Gianducaconte/algoradix-hardware/README.md

# Algoradix hardware

<p align="center">
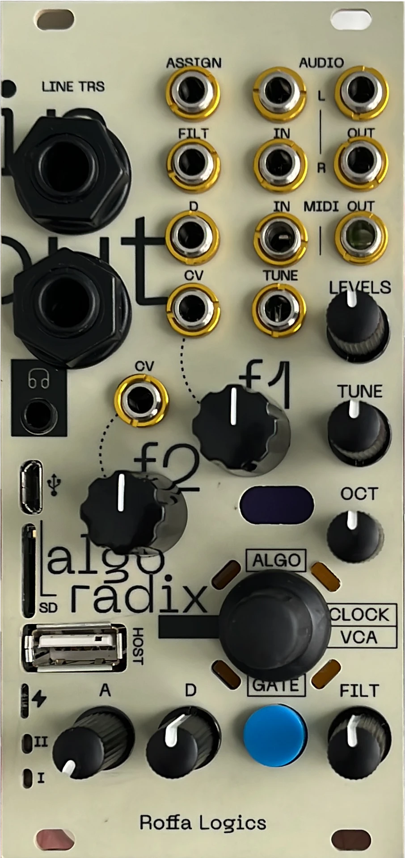
[picture p1: images/front-panel.png]
Algoradix front panel
  
</p>

**Algoradix** is a 12 HP Eurorack synth voice by **Roffa Logics**. It turns an
[Axoloti Core v1.2](https://github.com/axoloti/axoloti) into a playable module, with eight pots, six CV inputs, stereo
audio in and out, TRS MIDI in and out, a gate/function button, an encoder with four ring LEDs, and a small OLED. The
Core's own line jacks, headphone output, micro-SD, mini-USB and USB host port come through the panel.

This repository holds the open hardware: the **interface board**, the **connector board** that joins it to the
Core, the **front panel** (two colour variants), the BOM, the extracted netlist, assembly notes and photos. The
firmware is in the companion repository **[algoradix-firmware](https://github.com/Gianducaconte/algoradix-firmware)**.

| | |
|---|---|
| Format | Eurorack, 3U, 12 HP (panel 60.2 × 128.75 mm) |
| Brain | Axoloti Core v1.2: STM32F427 at 168 MHz, ADAU1961 24-bit codec at 48 kHz, 8 MB SDRAM, micro-SD |
| Controls | 8 pots (f1, f2, TUNE, OCT, A, D, FILT, LEVELS), EC11 encoder with push, GATE/FUNC button |
| CV inputs | f1, f2, TUNE (1 V/oct), D, FILT, ASSIGN. Summed with the pot in analog, 400 ADC counts per volt |
| Audio | stereo IN (attenuated to line level, right normalled to left), stereo OUT (amplified to Eurorack level) |
| MIDI | TRS IN and OUT on the panel, plus USB host (USB-A) on the Core |
| Display | SSD1306 OLED, 64 × 32, I2C |
| Power | Eurorack 10-pin, ±12 V |

## Design highlights

- **Compact.** A full Axoloti Core plus every jack, pot and the display fit in 12 HP: three boards stacked behind
  one panel, joined by a single 30-pin flat cable.
- **Real modular I/O, with protection in place.** CV inputs go through op-amps running on 3.3 V, so whatever is
  patched in, the STM32's ADC never sees a voltage outside 0…3.3 V. Each input also has a 1 kHz low-pass. Audio inputs
  are attenuated from Eurorack to line level, and outputs are amplified back up through 1 kΩ protection resistors.
  Eurorack power comes in through reverse-polarity diodes.
- **Pitch tracking from CV.** Each pot and its CV jack are summed in analog at a fixed 400 ADC counts per volt, so
  TUNE works as a 1 V/oct input.
- **A very small display.** A 0.49" 64 × 32 OLED, one of the smallest on the market, sits behind a pill-shaped
  window in the panel. The UI is designed around it: one big word per screen.
- **A PCB faceplate printed on aluminium.** The panel is an aluminium PCB with no silkscreen. The artwork is drawn
  in the **solder-mask layer, inverted**, so the PCB maker produces the print as part of the board itself. There's
  no silkscreen that might not grip on the aluminium, and the jack rings come out as plated copper.
- **Built before AI made rewriting easy, and still works both ways.** Algoradix was first designed to run patches
  from the stock Axoloti patcher, mapped onto the Core's GPIO, so the hardware works with Axoloti software too. Today
  it runs its own [firmware](https://github.com/Gianducaconte/algoradix-firmware), written from scratch.

## The build story

The PCBs were designed **in one week, in one go**, with a schematic covering only the fundamentals. The first
boards worked straight away. Only three sets were made. Every component was sourced directly from Mouser, TME and
Thonk, and everything was **assembled by hand**, including the tiny 0805 and SOIC parts on the back of the interface
board. You can see it in the [photos](#photos).

Three modules exist: two are in the designer's rack, and the third is in a friend's. **There are no plans to make more or to
sell them.** The design depends on the Axoloti Core, so it's published here instead: take it, learn from it, build on it. The [licence](#licence) keeps your derivatives open too.

## Contents

| Path | What |
|---|---|
| [`docs/architecture.md`](docs/architecture.md) | how the three boards and the Core fit together, power and signal flow |
| [`docs/interface-board.md`](docs/interface-board.md) | the interface board circuits: CV summing amplifiers, −10 V reference, audio in and out, controls |
| [`docs/pinout.md`](docs/pinout.md) | the 30-pin FPC between the boards, and every panel control mapped to its STM32 pin |
| [`docs/build-guide.md`](docs/build-guide.md) | ordering the boards and the panel, parts outside the BOM, assembly order, first power-up |
| [`pcb/interface-board/gerbers/`](pcb/interface-board/gerbers/) | Gerbers and drills, interface board (52.7 × 110.2 mm, 2 layers, SMD on the back) |
| [`pcb/connector-board/gerbers/`](pcb/connector-board/gerbers/) | Gerbers and drills, connector board (109.8 × 23.1 mm, 2 layers) |
| [`panel/variant-A/`](panel/variant-A/), [`panel/variant-B/`](panel/variant-B/) | front panel Gerbers, two artwork variants |
| [`bom/interface-board-bom.csv`](bom/interface-board-bom.csv) | interface board bill of materials (106 parts) |
| [`schematic/interface-board-netlist.txt`](schematic/interface-board-netlist.txt) | full netlist of the interface board |
| [`images/`](images/) | photos of the build, and renders of the boards and panels made from the Gerbers |

## The boards

<p>
Interface board, top
Interface board, bottom
Panel artwork, variant A
Panel artwork, variant B
</p>
Connector board, top

**Interface board.** All the panel jacks, pots, the encoder, the button and the ring LEDs. Three MCP6002 op-amps on
3.3 V sum each pot with its CV jack and scale the result to the 0–3.3 V range of the ADC. The rail-to-rail output also
protects the STM32 from out-of-range CV. Two TL072s on ±12 V buffer the audio: they bring Eurorack levels down to
line level for the codec, and line level back up for the outputs. One 30-pin FPC cable carries everything to the
connector board.

**Connector board.** Plugs onto the Core's GPIO header. It takes the FPC from the interface board, the Eurorack power
header (with reverse-polarity diodes), and breaks out power for the Core and the interface board, MIDI to the Core,
and an I2C header for the OLED.

**Panel.** An aluminium PCB with the artwork in the solder-mask layer, inverted, and no silkscreen (see
[panel/](panel/)). Variant A and variant B are the two colourways, and the photos show both.

## Photos

| | | |
|---|---|---|
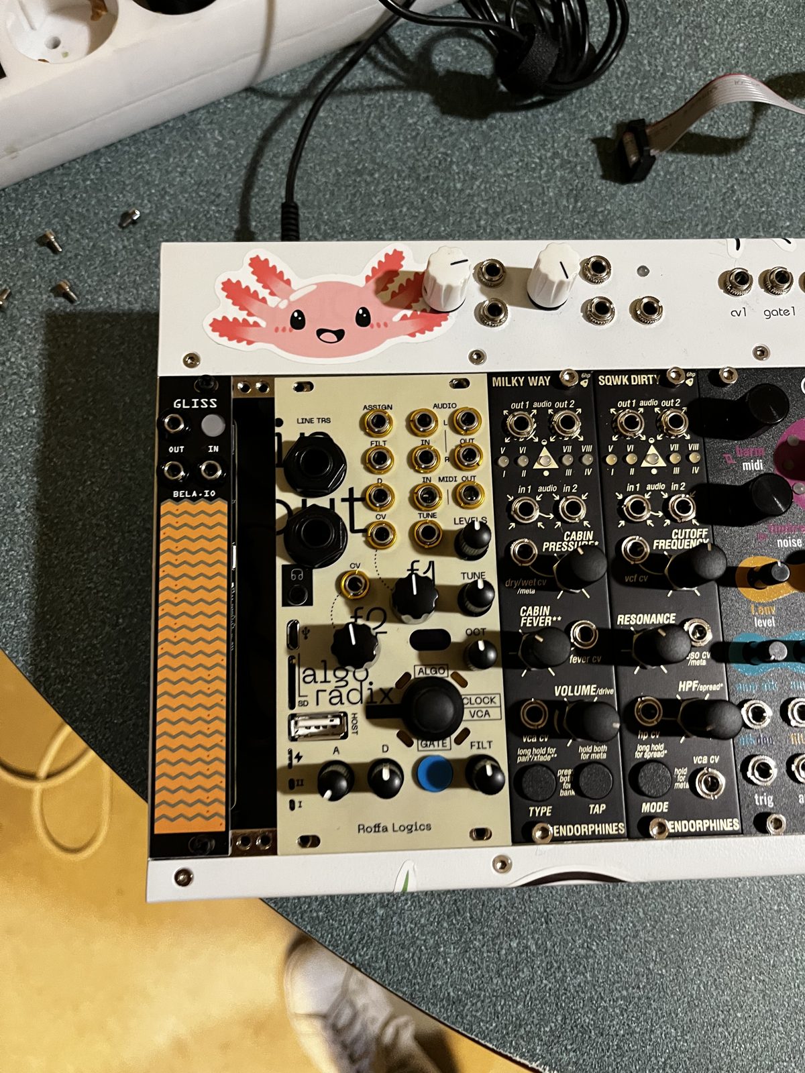
[picture p2: images/photos/03-in-rack.jpg]
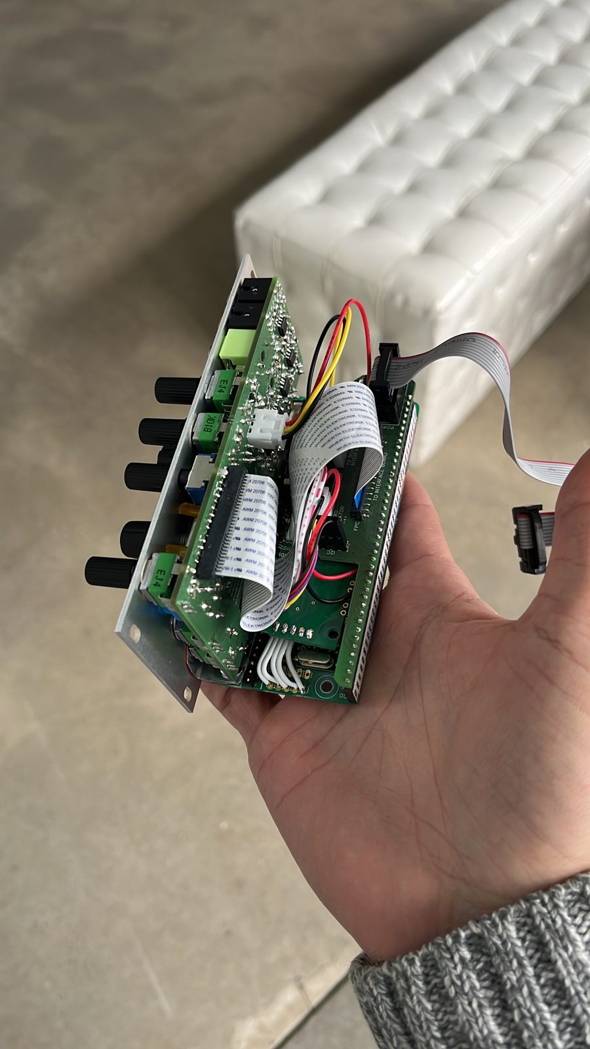
[picture p3: images/photos/02-side-stack.jpg]
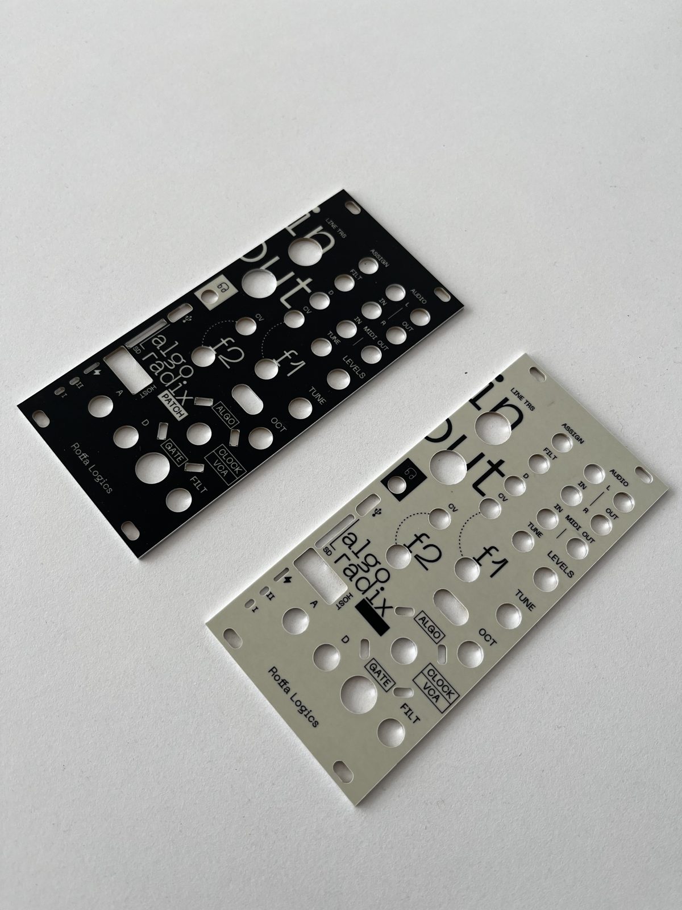
[picture p4: images/photos/04-panels-black-white.jpg]
|  |  |  |
| in the rack | the stack from the side | the two panel variants |
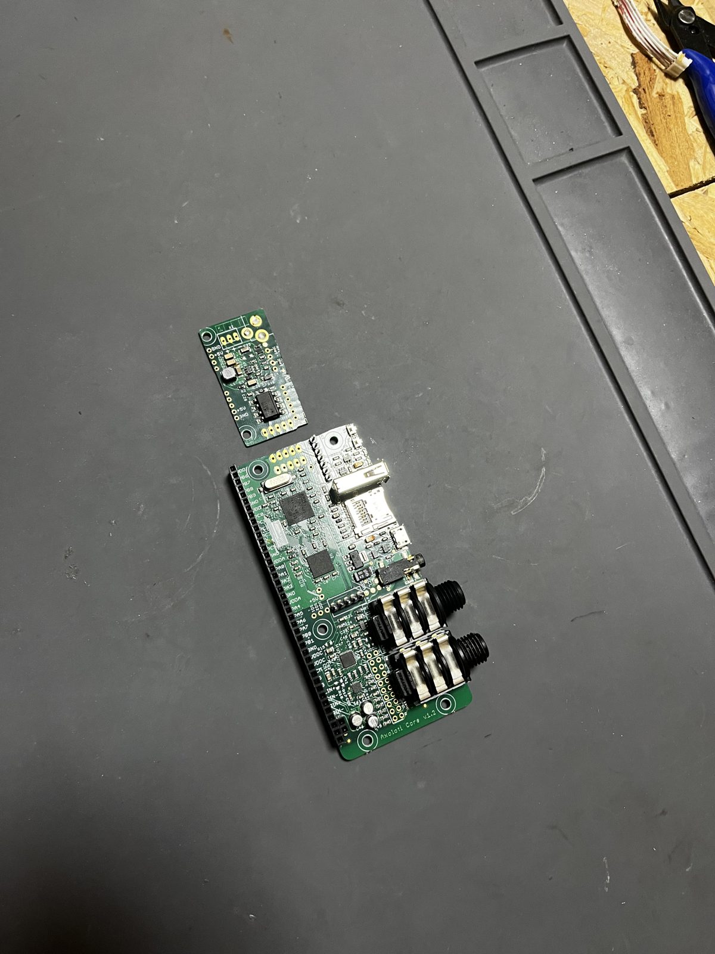
[picture p5: images/photos/07-core-and-connector.jpg]
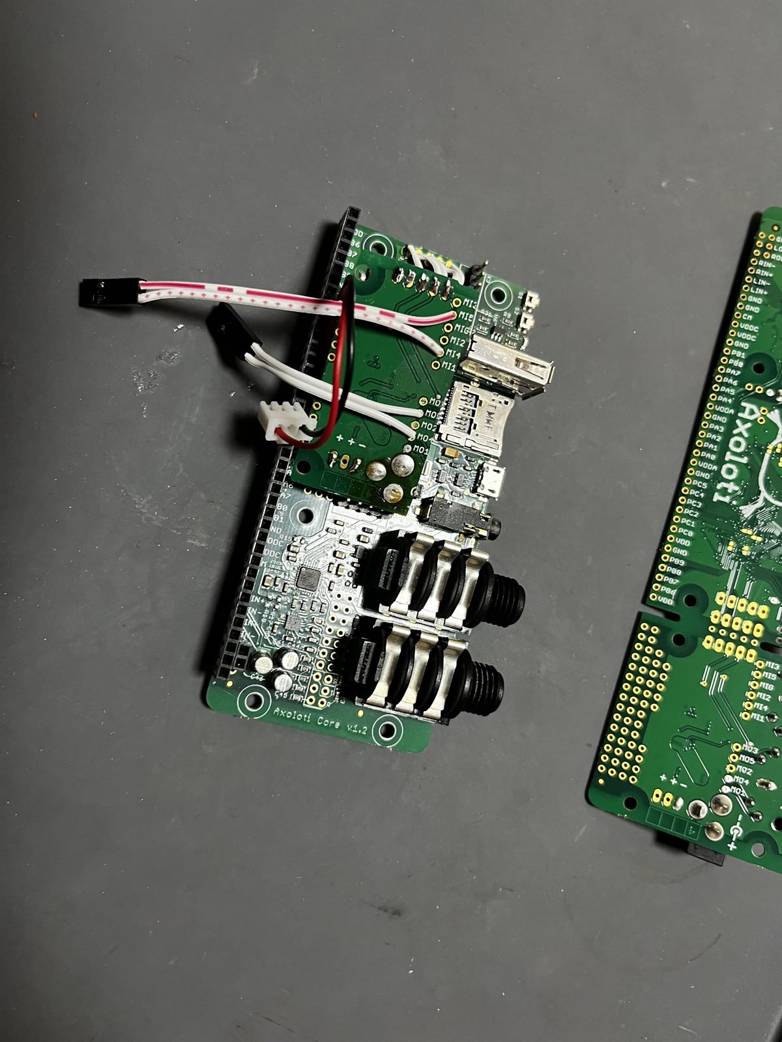
[picture p6: images/photos/08-core-with-connector-fitted.jpg]
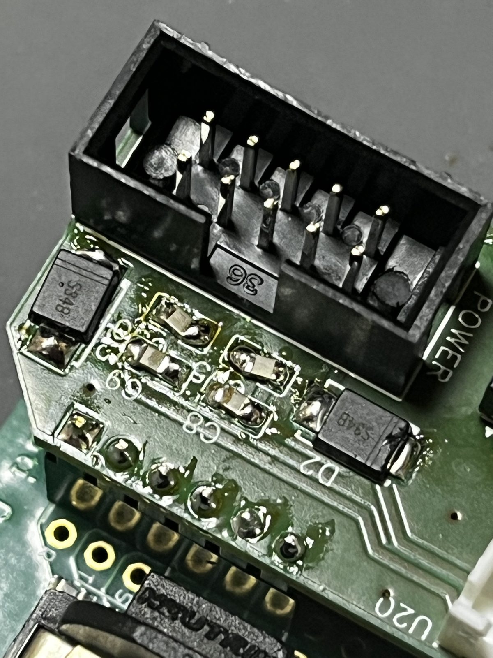
[picture p7: images/photos/09-connector-power-header.jpg]
|  |  |  |
| Axoloti Core and connector board | connector board fitted | Eurorack power header |
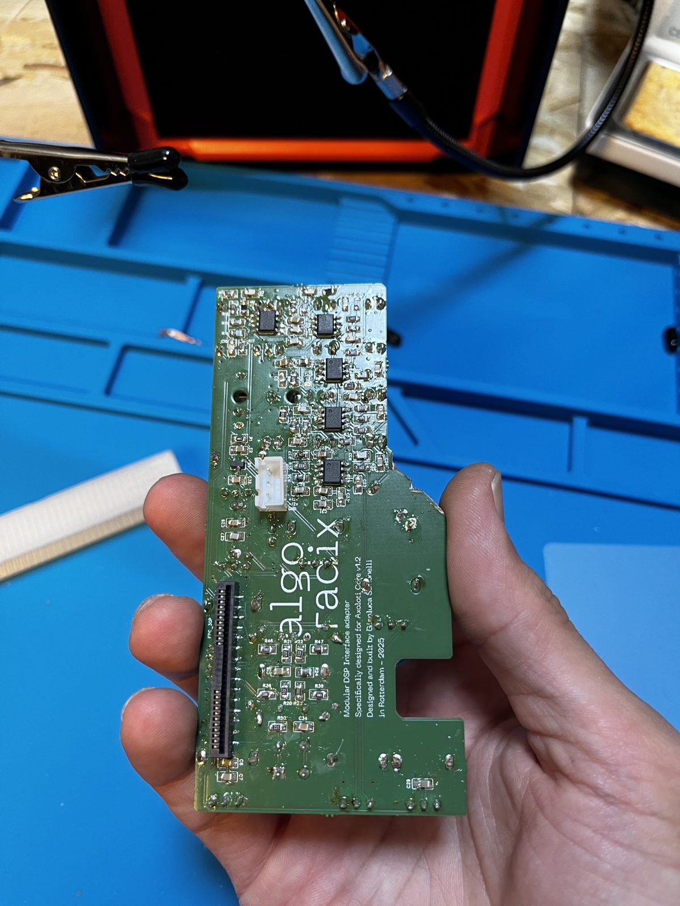
[picture p8: images/photos/11-interface-smd-side.jpg]
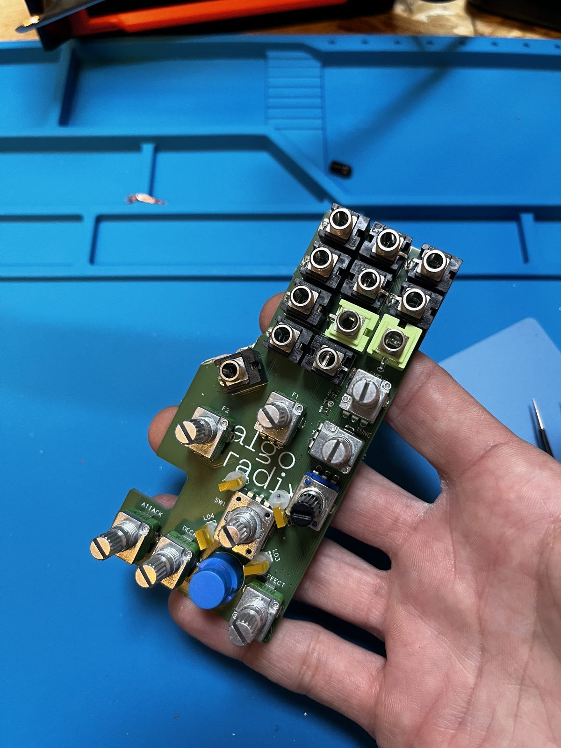
[picture p9: images/photos/13-interface-populated.jpg]
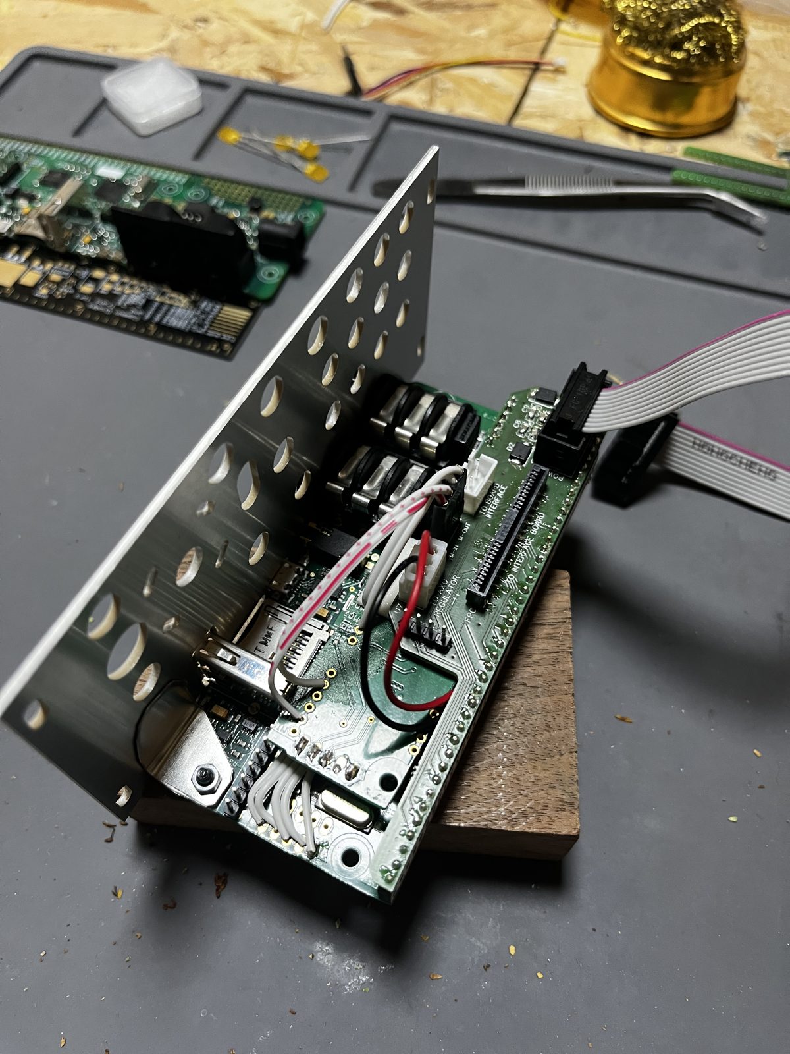
[picture p10: images/photos/14-assembly-behind-panel.jpg]
|  |  |  |
| interface board, SMD side | interface board populated | behind the panel |

More in [`images/photos/`](images/photos/).

## About the name

*Roffa* is slang for Rotterdam. The name came out of nowhere, and it stuck.

## Licence

Copyright © 2025–2026 Roffa Logics. Designed by Gianluca Simonelli.

This hardware is licensed under the **CERN Open Hardware Licence Version 2 – Strongly Reciprocal**
(CERN-OHL-S-2.0). See [LICENSE](LICENSE). You may redistribute and modify this documentation and make products
using it under the terms of the CERN-OHL-S v2 (https://ohwr.org/cern_ohl_s_v2.txt). This documentation is
distributed WITHOUT ANY EXPRESS OR IMPLIED WARRANTY, INCLUDING OF MERCHANTABILITY, SATISFACTORY QUALITY AND FITNESS
FOR A PARTICULAR PURPOSE. Please see the CERN-OHL-S v2 for applicable conditions.

The **Axoloti Core v1.2** is a separate open-hardware design by Johannes Taelman, published by the Axoloti project.
It isn't part of this repository and isn't covered by this licence. Algoradix is independent of the Axoloti project,
which hasn't endorsed it.
