Gianducaconte/algoradix-hardware/schematic/interface-board-netlist.txt

# Algoradix interface board, netlist extracted from the EasyEDA schematic (SCH_Axo-Module-AlgoRadix, 2026-01-22).
# One line per net: net name, then component.pin(pin name). Unnamed nets are numbered N001... in no particular order.
# MCP6002 op-amps carry the designators 0, 1 and 2 on the board.

+12V                 C10.2 C17.1 U1.8(VCC+) U2.8(VCC+) U3.3
-12V                 C11.1 C16.1 C2.1 D1.1(K) U1.4(VCC-) U2.4(VCC-) U3.2
3V3                  0.8(VDD) 1.8(VDD) 2.8(VDD) ATT.1 C3.1 C31.1 C32.1 C33.1 FPC1.10 LEVELS.1 OCT.1 R23.1 R24.2 S1.3(NO) S1.4(NO) SW1.5(S2)
5V                   FPC1.9
AREF_-10V            C2.2 D1.2(A) DECAY.1 EFFECT.1 F1.1 F2.1 R1.2 R3.1 TUNE.1
GND                  0.3(VINA+) 0.4(VSS) 0.5(VINB+) 1.3(VINA+) 1.4(VSS) 1.5(VINB+) 2.3(VINA+) 2.4(VSS) 2.5(VINB+) ASSIGN_CV.1(SLEVE/GND) ASSIGN_CV.2(SWITCH) ATT.3 C10.1 C11.2 C12.2 C13.2 C16.2 C17.2 C18.1 C19.2 C21.2 C24.2 C26.2 C27.2 C28.2 C29.2 C3.2 C31.2 C32.2 C33.2 C34.1 C5.2 C6.1 C7.1 DECAY.3 DECAY_CV.1(SLEVE/GND) DECAY_CV.2(SWITCH) EFFECT.3 EFFECT_CV.1(SLEVE/GND) EFFECT_CV.2(SWITCH) F1.3 F1_CV.1(SLEVE/GND) F1_CV.2(SWITCH) F2.3 F2_CV.1(SLEVE/GND) F2_CV.2(SWITCH) FPC1.11 FPC1.12 LD1.K(C) LD2.K(C) LD3.K(C) LD4.K(C) LEVELS.3 M_IN.P$1(1 S) M_OUT.P$1(1 S) OCT.3 R1.1 R10.1 R11.1 R15.2 R18.2 SW1.2(C) TUNE.3 TUNE_CV.1(SLEVE/GND) TUNE_CV.2(SWITCH) U18.1(SLEVE/GND) U19.1(SLEVE/GND) U3.1 U30.1(SLEVE/GND) U54.1(SLEVE/GND)
IN_L_PIN             FPC1.2 U1.1(1OUT) U1.2(1IN-)
IN_R_PIN             FPC1.4 U1.6(2IN-) U1.7(2OUT)
IO_1                 0.1(VOUTA) C4.1 FPC1.13 R5.2
IO_10                C34.2 FPC1.30 R50.1
IO_11                C18.2 FPC1.28 R20.1
IO_12                C6.2 FPC1.26 R21.1
IO_13                C7.2 FPC1.24 R22.2
IO_14                FPC1.22 R39.2
IO_15                FPC1.20 R46.2
IO_16                FPC1.18 R38.2
IO_17                FPC1.16 R47.2
IO_18(NC)            FPC1.14
IO_2                 0.7(VOUTB) C1.1 FPC1.15 R4.2
IO_3                 1.1(VOUTA) C20.1 FPC1.17 R27.2
IO_4                 1.7(VOUTB) C22.1 FPC1.19 R31.2
IO_5                 2.1(VOUTA) C25.1 FPC1.21 R35.2
IO_6                 2.7(VOUTB) C23.1 FPC1.23 R32.2
IO_7                 C28.1 FPC1.25 LEVELS.2
IO_8                 C27.1 FPC1.27 OCT.2
IO_9                 ATT.2 C29.1 FPC1.29
MIDI_IN_RING         FPC1.3 M_IN.P$2(2 R)
MIDI_IN_TIP          FPC1.1 M_IN.P$3(3 T)
MIDI_OUT_RING        FPC1.7 M_OUT.P$2(2 R)
MIDI_OUT_TIP         FPC1.5 M_OUT.P$3(3 T)
N001                0.2(VINA-) C4.2 R5.1 R6.2 R7.2
N002                0.6(VINB-) C1.2 R2.2 R3.2 R4.1
N003                1.2(VINA-) C20.2 R25.2 R26.2 R27.1
N004                1.6(VINB-) C22.2 R29.2 R30.2 R31.1
N005                2.2(VINA-) C25.2 R35.1 R36.2 R37.2
N006                2.6(VINB-) C23.2 R32.1 R33.2 R34.2
N007                ASSIGN_CV.3(TIP) R2.1
N008                C12.1 R10.2 R8.2 R9.2 U1.3(1IN+)
N009                C13.1 R11.2 R12.2 R13.2 U1.5(2IN+)
N010                C14.1 R14.2 R16.1 U2.1(1OUT)
N011                C14.2 R14.1 R15.1 U2.2(1IN-)
N012                C15.1 R17.1 R19.2 U2.7(2OUT)
N013                C15.2 R18.1 R19.1 U2.6(2IN-)
N014                C19.1 F1.2 R26.1
N015                C21.1 F2.2 R30.1
N016                C24.1 DECAY.2 R33.1
N017                C26.1 R36.1 TUNE.2
N018                C5.1 EFFECT.2 R6.1
N019                D1.3(NC)
N020                DECAY_CV.3(TIP) R34.1
N021                EFFECT_CV.3(TIP) R7.1
N022                F1_CV.3(TIP) R25.1
N023                F2_CV.3(TIP) R29.1
N024                LD1.A R46.1
N025                LD2.A R47.1
N026                LD3.A R38.1
N027                LD4.A R39.1
N028                R12.1 R13.1 U30.3(TIP)
N029                R16.2 U18.3(TIP)
N030                R17.2 U19.3(TIP)
N031                R20.2 SW1.4(S1)
N032                R21.2 R24.1 SW1.1(A)
N033                R22.1 R23.2 SW1.3(B)
N034                R37.1 TUNE_CV.3(TIP)
N035                R50.2 S1.1(COM) S1.2(COM)
N036                R8.1 R9.1 U30.2(SWITCH) U54.3(TIP)
N037                U18.2(SWITCH)
N038                U19.2(SWITCH)
N039                U54.2(SWITCH)
OUT_L_PIN            FPC1.6 U2.3(1IN+)
OUT_R_PIN            FPC1.8 U2.5(2IN+)
