Gianducaconte/algoradix-hardware/images/photos/01-front-panel.jpg

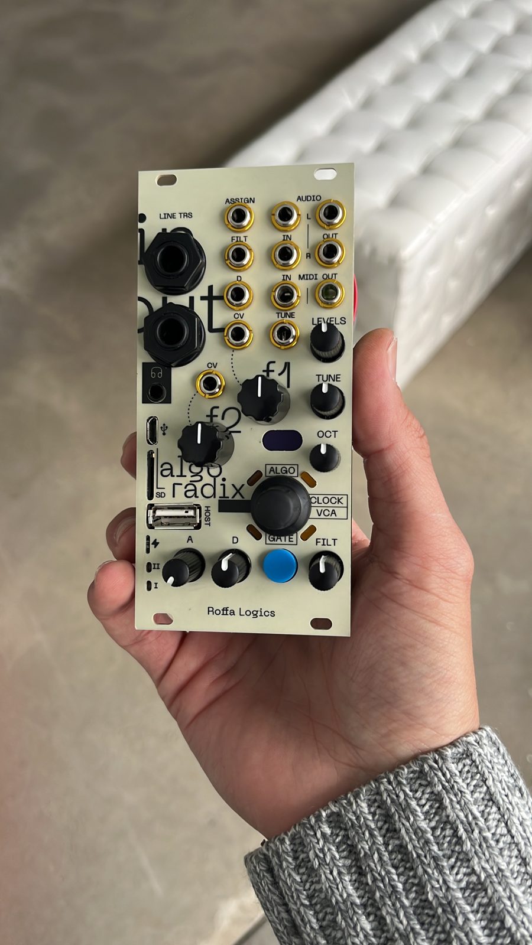
images/photos/01-front-panel.jpg
