Gianducaconte/algoradix-hardware/images/photos/05-panels-back.jpg

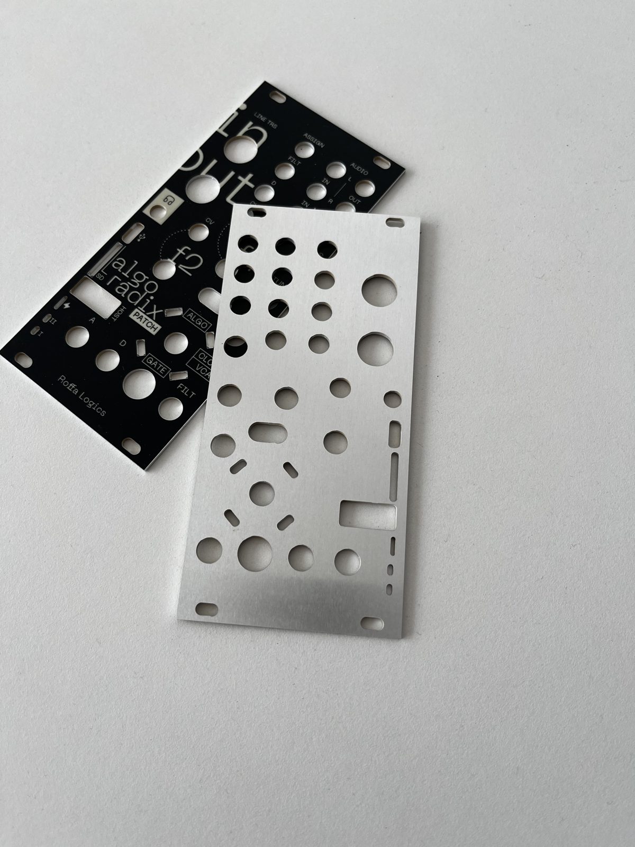
images/photos/05-panels-back.jpg
