Gianducaconte/algoradix-hardware/images/photos/06-connector-boards-bare.jpg

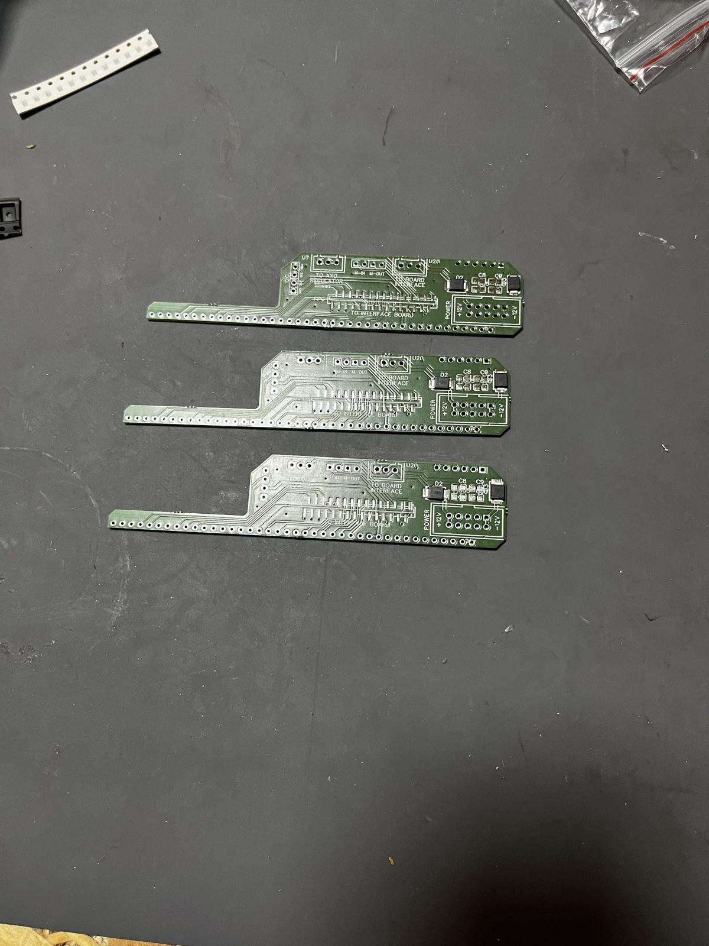
images/photos/06-connector-boards-bare.jpg
