Gianducaconte/algoradix-hardware/images/photos/12-interface-jacks-pots.jpg

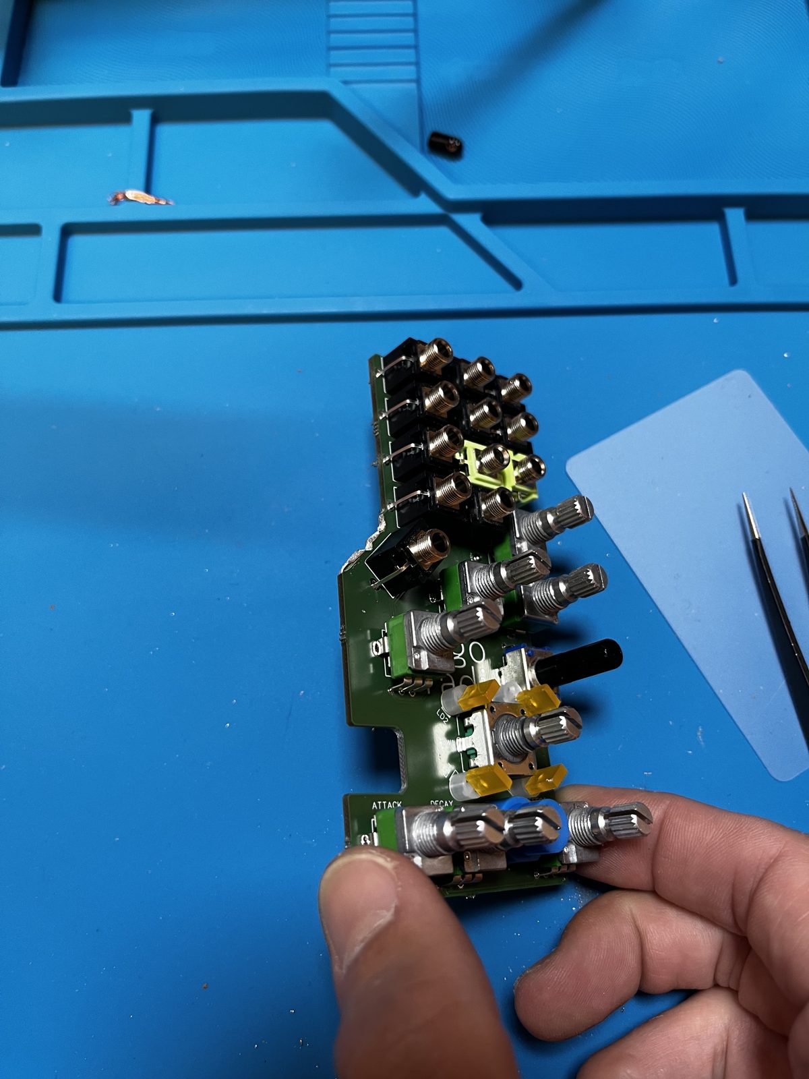
images/photos/12-interface-jacks-pots.jpg
