Gianducaconte/algoradix-hardware/images/photos/10-interface-soldering.jpg

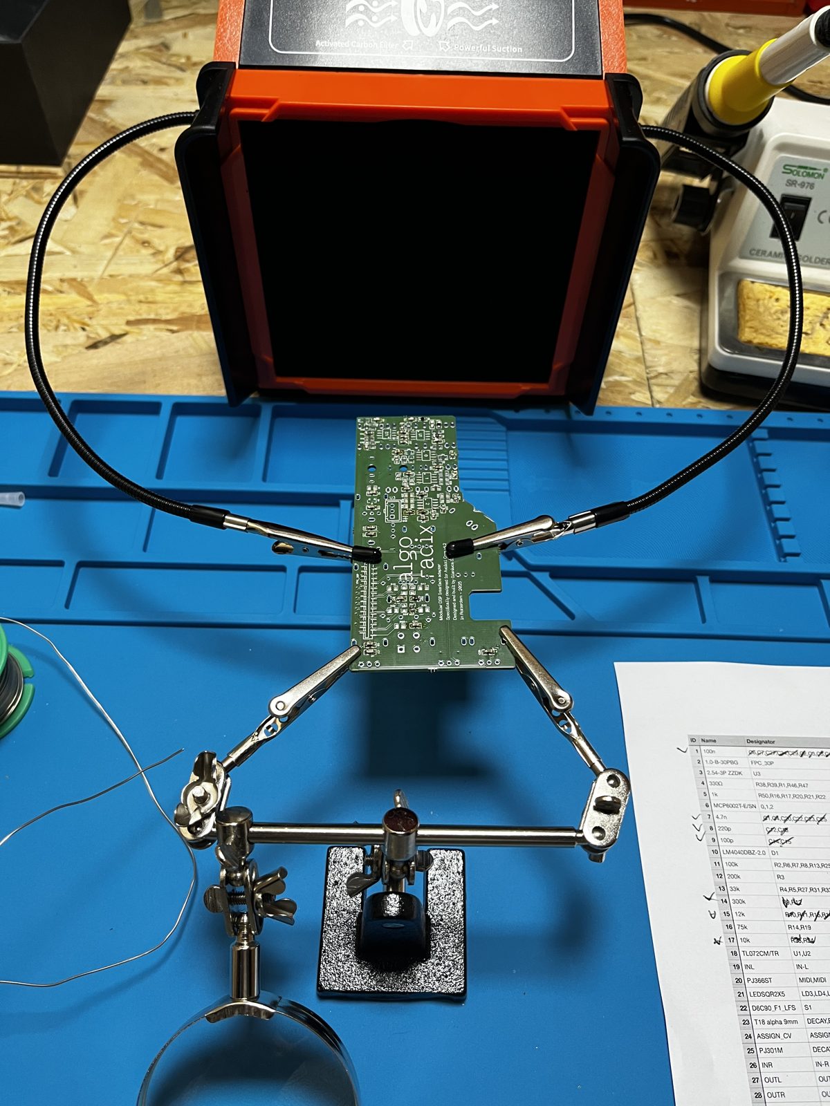
images/photos/10-interface-soldering.jpg
