Gianducaconte/algoradix-hardware/images/photos/15-assembly-wiring.jpg

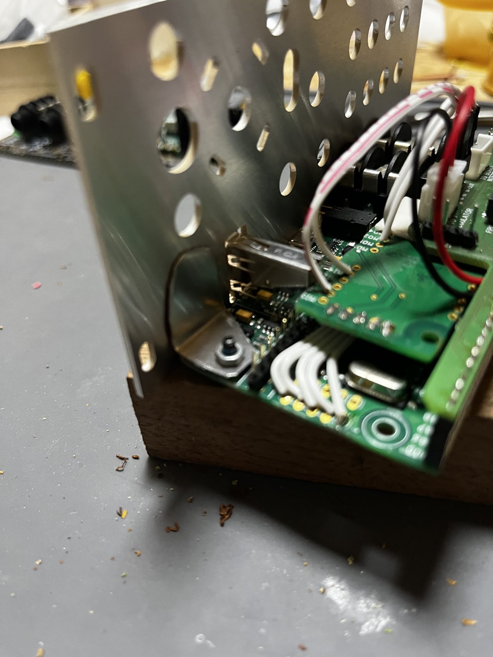
images/photos/15-assembly-wiring.jpg
