Gianducaconte/algoradix-hardware/(commit log)

2026-11-04 Algoradix hardware v1.0: first public release
    [Drill_NPTH_Through.DRL, Drill_PTH_Through.DRL, Drill_PTH_Through_Via.DRL, Gerber_BoardOutlineLayer.GKO, Gerber_BottomLayer.GBL, Gerber_BottomPasteMaskLayer.GBP, Gerber_BottomSilkscreenLayer.GBO, Gerber_BottomSolderMaskLayer.GBS]
2026-11-04 Clean front-panel photo as the README image; the GATE / FUNC button is blue
    [interface-board-bom.csv]
2026-11-04 README: design highlights, the aluminium panel with inverted solder mask, the name
